0x23/MicroManipulator/construction_metric/attachments_variation1/Gripper1-M3-clearance.FCStd

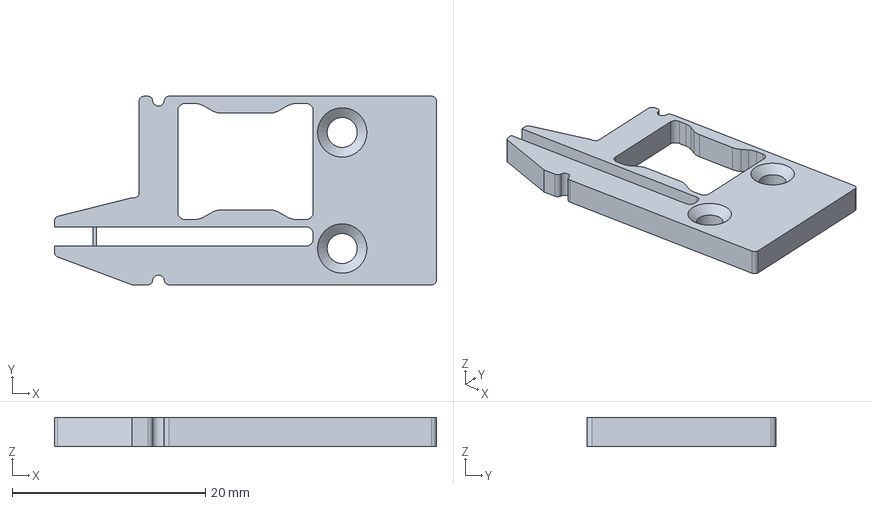
[picture p1: CAD file, 2025-08-28]
construction_metric/attachments_variation1/Gripper1-M3-clearance.FCStd
39.5 x 19.5 x 3.00 mm
