0x23/MicroManipulator/construction_metric/v2_variation1/EndEffector-M3-inserts.FCStd

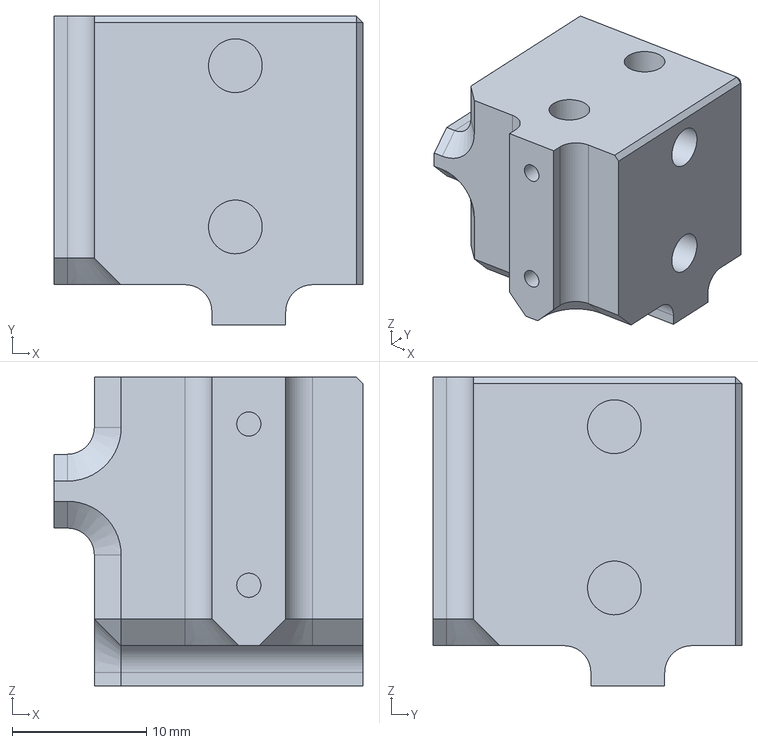
[picture p2: CAD file, 2025-08-28]
construction_metric/v2_variation1/EndEffector-M3-inserts.FCStd
23.0 x 23.0 x 23.0 mm
