0x23/MicroManipulator/(threads)

Thread 1 (2025-06-15):

Discussion - option for improving the fit and feel of handwheel

joshwills, 2025-06-15:
Following up from what I posted on youtube, this is my suggestion for improving the feel of the handwheel:

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

I understand your point from your youtube reply about the o-ring preload, but I think that eliminating the play caused by the handwheel being loose will definitely improve the feel and fine manipulation control of the stages; the o-ring will still serve to improve the precise positioning by preloading the stage's drive nut against the screw thread in only one direction.

As I said before, the washers could also be replaced by actual thrust bearings; a common seller on a common ecommerce platform has a 10-pack of "F3-8M" thrust ball bearings for sale for USD$10.

Thread 2 (2025-06-17):

Clarify Screw Types in BOM (Countersunk vs. Cylindrical)

fkay1, 2025-06-17:
Hi,

I’m planning to build the project and was about to order the screws. While watching the [assembly video](https://www.youtube.com/watch?v=-mgqq0qdDRM), I noticed that **not all screws are countersunk**, although the BOM lists only those.

Using countersunk screws in non-countersunk holes doesn't look great and might affect the fit. It would be very helpful if the BOM could reflect the actual screw head types.

I tried reverse-engineering the usage from the video — here's my current guess:

### Estimated Screw Usage

| Part                  | Type            | Qty | Size
|-----------------------|------------------|-----|--------------|
| Flexure Stages        | Cylindrical      | 3*3=9  | M3 x 18mm?   |
| O-Ring Mounts         | Countersunk| 4*3=12   | M2.5 x 6mm? |
| Flexure Stage Base    | Countersunk      | 3*3 =9  | M3 x ???     |
| Leadscrew Wheels      | Countersunk      | 1*3=3   | M3 x 30mm    |
| Wire Mounts           | Countersunk | 4*3=12   | M2 x 8mm     |

I don't understand where all the other screws mentioned in the BOM are supposed to go.
Would you mind verifying this and updating the BOM accordingly? That would help a lot for me and others building this project.

Thanks again for this great project!

0x23, 2025-07-10:
Thanks for spotting the prooblem. I updated the BOM and added a description. Please check if it makes sense for you now.
